TactileVision/CollabJam-PCB/v1/CollabJam.kicad_pcb

## KiCad design v1/CollabJam.kicad_pcb (2023-05-02, an earlier design)

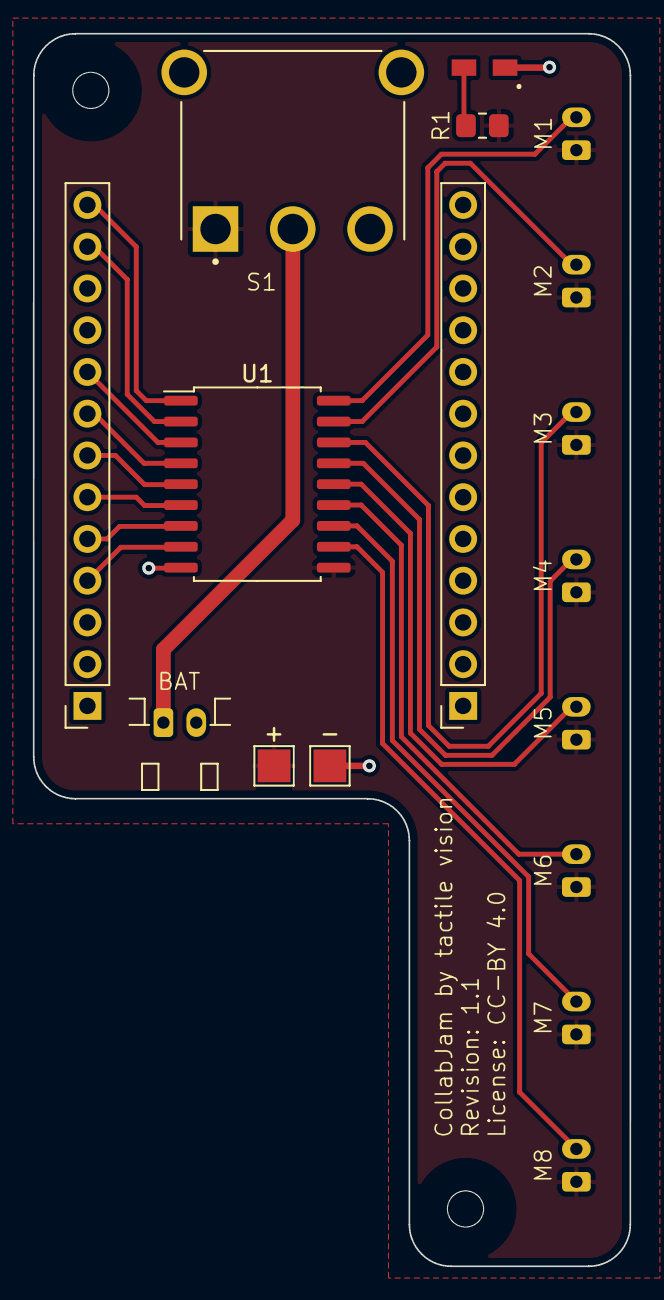
[picture p8: board v1/CollabJam.kicad_pcb from above]

Board: 2 copper layers, 36.3 x 75.0 mm, 19 parts (0 on the bottom side), 20 nets.

Parts:
+: ESP_BAT_PWR; TestPoint_Pad_2.0x2.0mm
-: ESP_BAT_GND; TestPoint_Pad_2.0x2.0mm
BAT: Power; JST_PH_S2B-PH-K_1x02_P2.00mm_Horizontal
D1: LED; LTSTS220KFKT
H1, H2: MountingHole; MountingHole_2.2mm_M2
J10: ESP32 right; PinSocket_1x13_P2.54mm_Vertical
J11: ESP32 left; PinSocket_1x13_P2.54mm_Vertical
M1: M1; JST_PH_S2B-PH-K_1x02_P2.00mm_Horizontal
M2: M2; JST_PH_S2B-PH-K_1x02_P2.00mm_Horizontal
M3: M3; JST_PH_S2B-PH-K_1x02_P2.00mm_Horizontal
M4: M4; JST_PH_S2B-PH-K_1x02_P2.00mm_Horizontal
M5: M5; JST_PH_S2B-PH-K_1x02_P2.00mm_Horizontal
M6: M6; JST_PH_S2B-PH-K_1x02_P2.00mm_Horizontal
M7: M7; JST_PH_S2B-PH-K_1x02_P2.00mm_Horizontal
M8: M8; JST_PH_S2B-PH-K_1x02_P2.00mm_Horizontal
R1: 100; R_0805_2012Metric_Pad1.20x1.40mm_HandSolder
S1: 500SSP1S1M6QEA; SW_500SSP1S1M6QEA
U1: ULN2803A; SOIC-18W_7.5x11.6mm_P1.27mm

Connections:
/M1: M1.2, U1.18 (O1)
/M2: M2.2, U1.17 (O2)
/M3: M3.2, U1.16 (O3)
/M4: M4.2, U1.15 (O4)
/M5: M5.2, U1.14 (O5)
/M6: M6.2, U1.13 (O6)
/M7: M7.2, U1.12 (O7)
/M8: M8.2, U1.11 (O8)
ESP_GPIO04: J11.9, U1.3 (I3)
ESP_GPIO05: J11.6, U1.6 (I6)
ESP_GPIO13: J11.13, U1.1 (I1)
ESP_GPIO15: J11.12, U1.2 (I2)
ESP_GPIO16: J11.8, U1.4 (I4)
ESP_GPIO17: J11.7, U1.5 (I5)
ESP_GPIO18: J11.5, U1.7 (I7)
ESP_GPIO23: J11.4, U1.8 (I8)
GND: -.1, BAT.2, D1.1 (K), J10.13, U1.9 (GND)
unnamed: D1.2 (A), R1.2
PWR: +.1, M1.1, M2.1, M3.1, M4.1, M5.1, M6.1, M7.1, M8.1, R1.1, S1.1, U1.10 (COM)
VCC: BAT.1, S1.2
