TactileVision/CollabJam-PCB/(notices)

Notices in the files:
v1/CollabJam.kicad_pcb:
License: CC-BY 4.0
